g0hwan/Automated-Aquaponics-System/Mentoring/Readme.md

한이음 관련 멘토링 내용이 담길 예정입니다.

2026-04-12 18:00
랩에서 미팅

1.현재 하드웨어 상황 점검
 - 수경 재배 용 수조 관련 구현 중
 - 발아 환경에서 조명 이슈로 성장 차이 발생
    조명 온오프 조정으로 성장 조절 가능성 검토
 - 수확을 위한 그리퍼 적용된 로봇팔 구현 중

2.일정 및 관련 이슈
 - 졸업작품 심사대응 일정으로 진행
 - 구현 일정을 타이트하게 진행하여 마진을 확보하여 리스크 확보

3.기타
 - 시장에서 많이보이는 수경재배 제품에 관련하여 특징 및 장단점 검토
 - 4월은 중간고사 기간으로 시험 끝나면 추가 미팅진행예정

2026-05-21

1. 바이브 코딩 세미나 : 강의실
2. 프로젝트 진행상황 리뷰 : 랩

3. 바이브 코딩 세미나
   - 18:00 ~ 20:30
   - 인원 : 조희재강사(삼성전자) / 임세훈(멘토) / 김경환(멘티) / ----(청강)
   - 진행
       . VScode 워크스페이스 설정 및 코파일럿 설정 / 코덱스 설정
       . 채팅창을 이용한 코드 실습 : ESP32 + 네오LED
       . 사양서를 이용한 코드 실습 : ESP32 + 네오 LED + Wifi
       . AI에이전트 활용시 효율 올리는 방법 및 사양서의 중용성 / 기본템플릿 소개등
4. 프로젝트 리뷰
   - 20:30 ~21:00
   - 진행상황 및 이슈
      . 녹조발생관련 토론 : 조희재 강사의 무환수 어항 노하우 전달
                           바닥재 종류 바꾸기 / 달팽이와 새우를 이용한 녹조제거 등
5. 기타
 - 바이브 코딩은 추가 세미나 가능하며 일정확인
 - GITHUB활용건에대한 세미나도 추가

   2026-06-26 20:00
   1. 랩에서 진행상황미팅
      -  개발 상황 리뷰
      -  이슈검토 : 양액을 사용하면서 EC센서값 증가는 바닥재 등으로 정리되지만 PH가 증가하고있음
                   물고기 투입시 폐사 위험있어 데모는 소형 물고기 장난감으로 진행
      - 중간고사 완료되었으며 종강. 프로젝트 완성을 미리 하고 자료 정리등으로 일정 안배
      - 중간보고서 일정 확인 및 작성후 리뷰예정
   2. 회식
      - 근처 오이도 이동후 회식진행 : 상반기 노고 치하및 팀 화이팅 진행

      2026-07-31 19:30
 1. 기술혁신 파크 1층 스터디까페
   - 월요일 졸업작품 발표회 관련
     . 월요일 졸작발표회에서 스칼라 로봇의 고장발생이슈
     . 홍보용 촬영대응을 위해 수리 및 가동 점검 필요
   - 현업에서 AI 활용이슈
     . 보안이슈로 많은 제약이 있었지만 cluade 를 비롯한 다양한 AI 툴의 사용이 가능함.
     . 코드 생성 및 문서/ 분석등에서 산출물이 풍부하고 정확함. 생산성이 매우 높음. 이는 이전으로의 원복이 어려울것으로 보임
     . 학생일때 다양한 AI를 활용해볼것을 조언 
 2. 랩에서 프로젝트 체크
   - 발표를위해 이동을 하면서 분리된상태.
   - 한이음 최종 보고서 및 학교 홍보 영상 촬영을 위해 재조립은 필요한상화
 3. 기타
  - 중간 보고서 제출완료 및 우수 프로젝트 선정 축하
  - 미팅이후 석식으로 응원함.
