g0hwan/Automated-Aquaponics-System/Mentoring/KakaoTalk_20260523_161338244_03.jpg

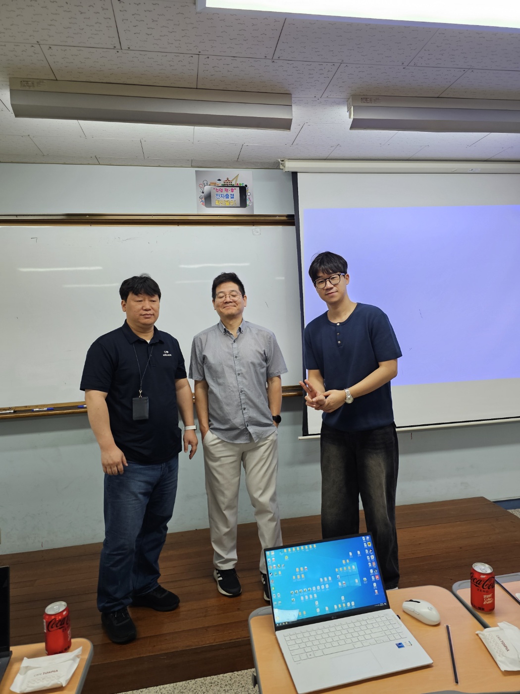
Mentoring/KakaoTalk_20260523_161338244_03.jpg
