g0hwan/Automated-Aquaponics-System/Mentoring/KakaoTalk_20260731_212931301_01.jpg

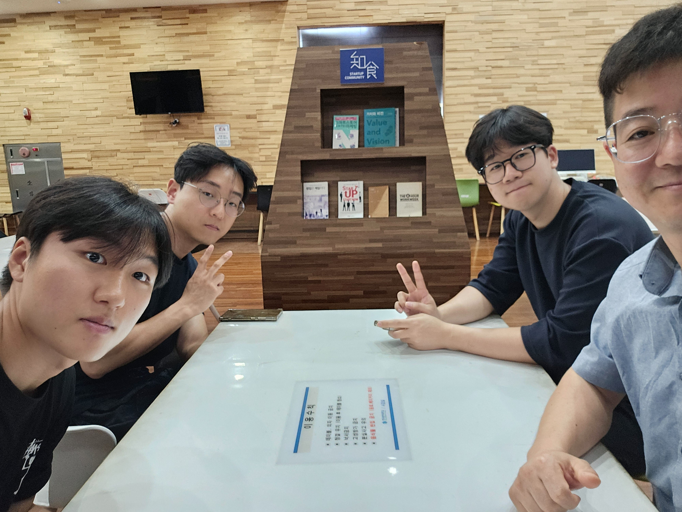
Mentoring/KakaoTalk_20260731_212931301_01.jpg
