g0hwan/Automated-Aquaponics-System/nursery/DS18B20_circuit.png

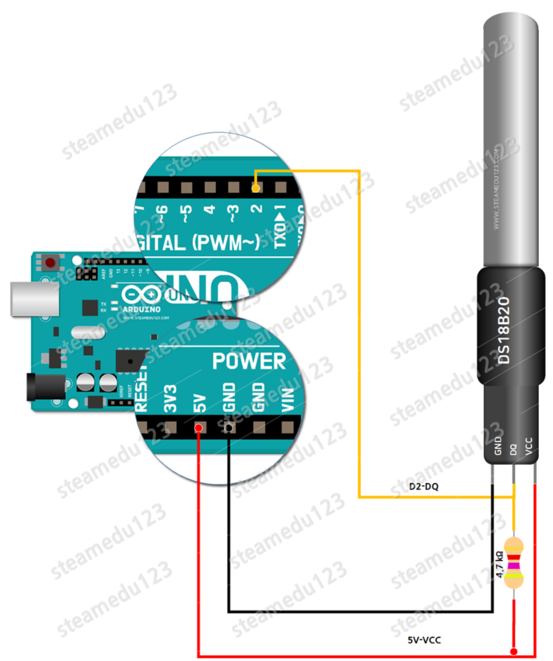
nursery/DS18B20_circuit.png
