g0hwan/Automated-Aquaponics-System/Mentoring/pc_ads1292r_brk_v3.pdf

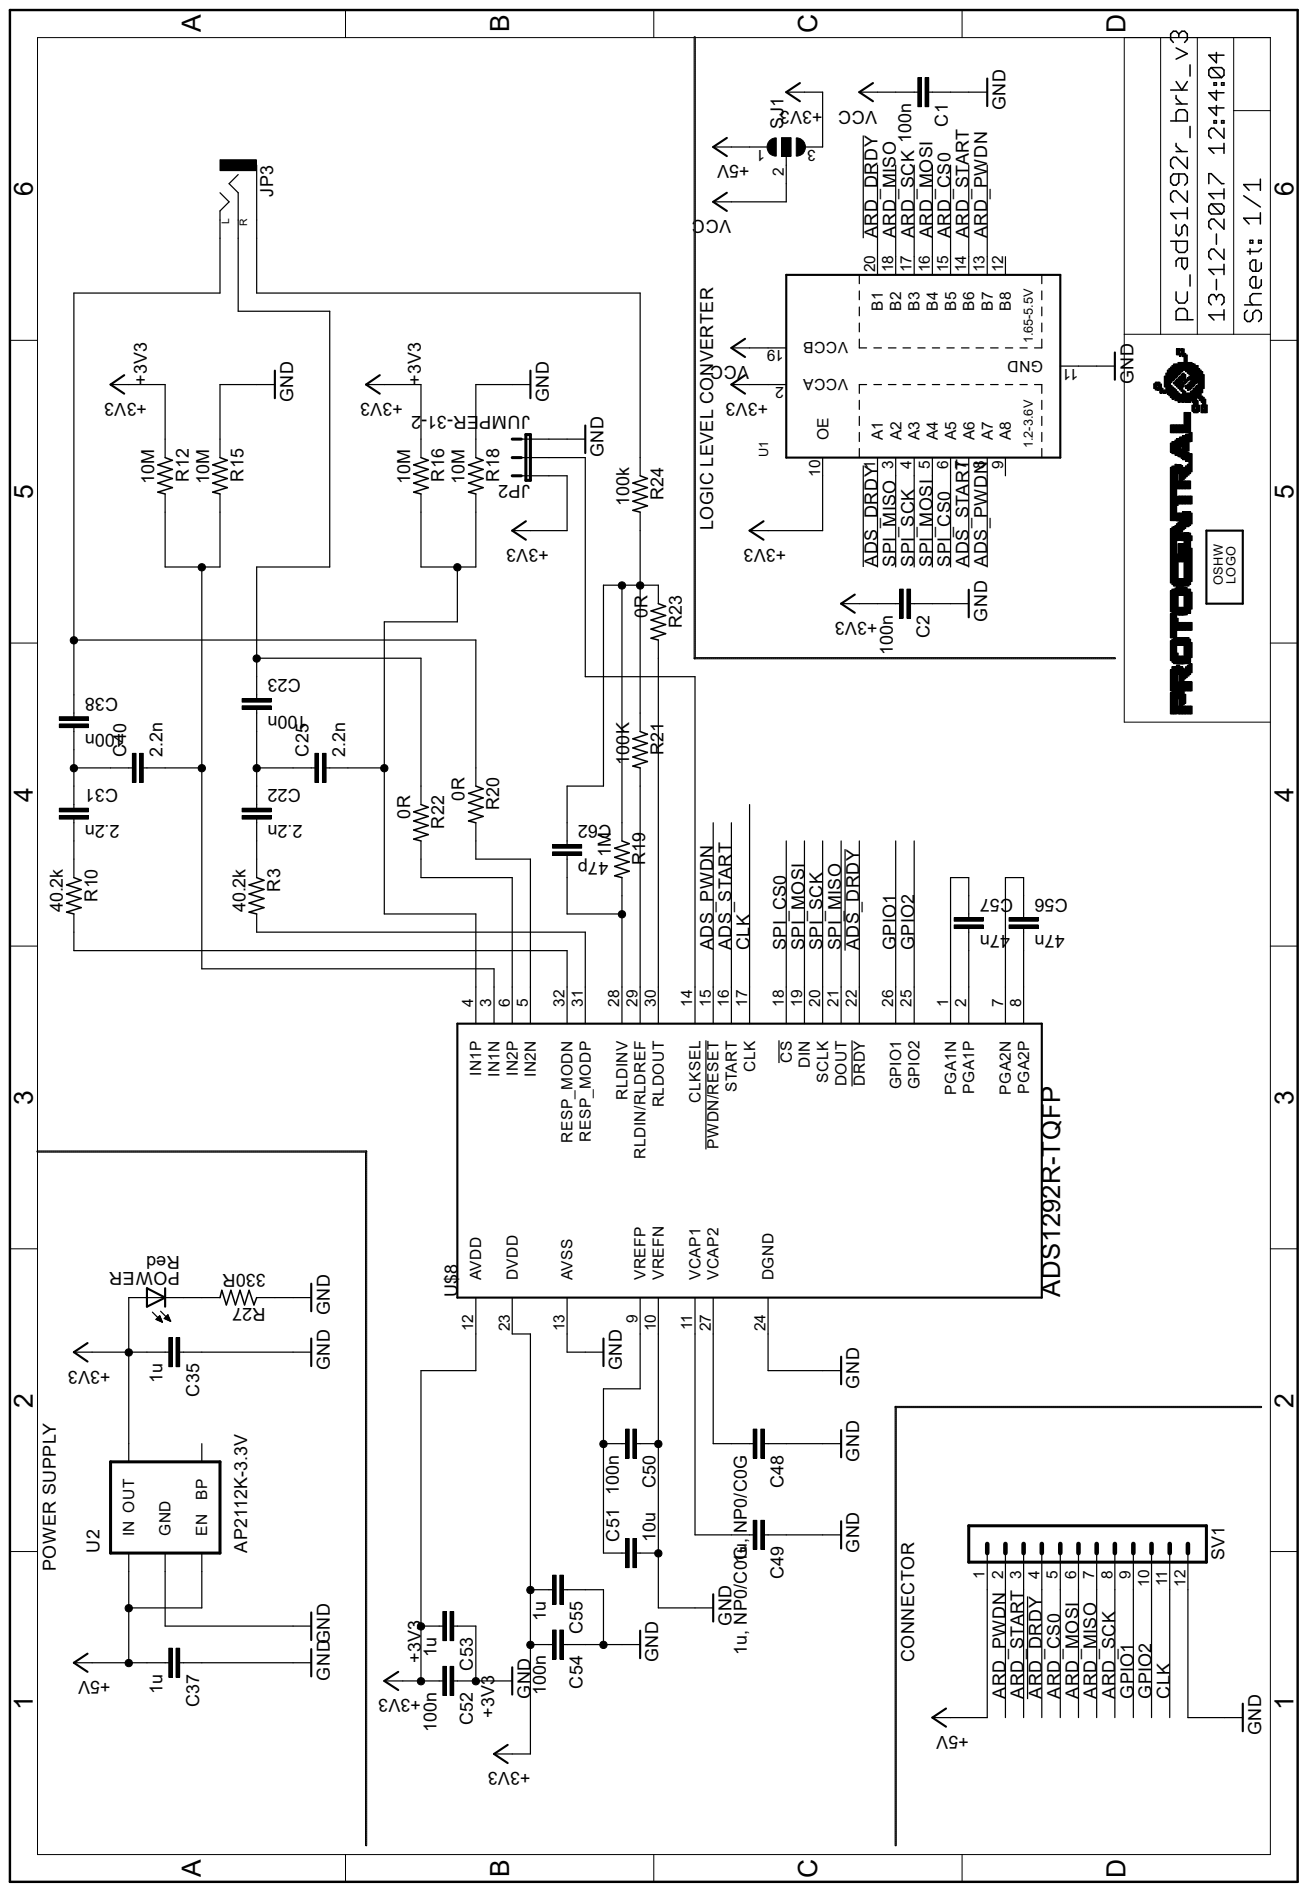
[picture p54: page 1]

2 U2INGNDOUT EN BP ADS_DRDY ADS_DRDY SPI_MISO SPI_MISO SPI_SCK SPI_SCK SPI_MOSI SPI_MOSI SPI_CS0 SPI_CS0 ADS_PWDN ADS_PWDN ADS_START ADS_START +3V3 +3V3 +3V3 +3V3 ARD_MOSI ARD_MOSI ARD_MISO ARD_MISO ARD_SCK ARD_SCK ARD_CS0 ARD_CS0 ARD_DRDY ARD_DRDY ARD_START ARD_START ARD_PWDN ARD_PWDN CLK CLK GPIO1 GPIO1 GPIO2 GPIO2

4 DIN 19 DOUT 21 SCLK 20 CS 18 DRDY 22 AVDD 12 AVSS 13 DVDD 23 GPIO1 26 GPIO2 25 RLDINV 28 RLDIN/RLDREF 29 RLDOUT 30 VREFP

9 VREFN 10 VCAP1 11 VCAP2 27 DGND 24 RESP_MODN 32 RESP_MODP 31 PWDN/RESET 15 CLK 17 START 16 CLKSEL 14 PGA1N
