g0hwan/Automated-Aquaponics-System/nursery/sens_hub/sens_hub.ioc

Mcu.UserName=STM32F446RETx
PA0-WKUP.Signal=ADCx_IN0
PA1.Signal=ADCx_IN1
PA2.Signal=USART2_TX
PA3.Signal=USART2_RX
PA4.Signal=GPIO_Output
PB0.Signal=GPIO_Output
PC0.Signal=GPIO_Output
