g0hwan/Automated-Aquaponics-System/nursery/sens_hub/Core/Src/main.c

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
/* Includes ------------------------------------------------------------------*/
#include "main.h"

/* USER CODE BEGIN Includes */
#include "sens.h"
#include "dht.h"
#include "ds18b20.h"
#include "relay_control.h"
/* USER CODE END Includes */

/* USER CODE BEGIN PTD */
void microDelay (uint16_t delay);
/* USER CODE END PTD */

ADC_HandleTypeDef hadc1;
ADC_HandleTypeDef hadc2;

TIM_HandleTypeDef htim2;
TIM_HandleTypeDef htim3;

UART_HandleTypeDef huart2;

void SystemClock_Config(void);
static void MX_GPIO_Init(void);
static void MX_ADC1_Init(void);
static void MX_ADC2_Init(void);
static void MX_TIM2_Init(void);
static void MX_USART2_UART_Init(void);
static void MX_TIM3_Init(void);
/* USER CODE BEGIN PFP */
void DWT_Delay_Init(void);
/* USER CODE END PFP */

/* USER CODE BEGIN 0 */
volatile uint32_t ms_tick = 0;
uint32_t t0 = 0;
uint8_t state = 0; // 0: idle, 1: waiting
/* USER CODE END 0 */

/**
  * @brief  The application entry point.
  * @retval int
  */
int main(void)
{

  /* MCU Configuration--------------------------------------------------------*/

  /* Reset of all peripherals, Initializes the Flash interface and the Systick. */
  HAL_Init();

  /* Configure the system clock */
  SystemClock_Config();

  /* USER CODE BEGIN SysInit */
  DWT_Delay_Init();
  /* USER CODE END SysInit */

  /* Initialize all configured peripherals */
  MX_GPIO_Init();
  MX_ADC1_Init();
  MX_ADC2_Init();
  MX_TIM2_Init();
  MX_USART2_UART_Init();
  MX_TIM3_Init();
  /* USER CODE BEGIN 2 */

  Relay_Init();

  HAL_TIM_Base_Start_IT(&htim2);
  HAL_ADC_Start(&hadc1);
  HAL_ADC_Start_IT(&hadc1);
  HAL_ADC_Start(&hadc2);
  HAL_ADC_Start_IT(&hadc2);
  HAL_TIM_Base_Start_IT(&htim3);
  /* USER CODE END 2 */

  /* Infinite loop */
  /* USER CODE BEGIN WHILE */
  while (1)
  {
	  if (ph_flag==1)
	  {
	      printf("tds = %lu, ph = %.2f\r\n", (unsigned long)tds_value, ph_value);

	      Relay_Control(ph_value, tds_value);

	      ph_flag = 0;
	  }
	  if(dht_flag)
	  {
	    dht_flag = 0;

	    float t,h;

	    uint32_t primask = __get_PRIMASK();
	    __disable_irq();                 // ✅ DHT 읽는 동안 인터럽트 금지

	    uint8_t ok = DHT22_Read(&t, &h);

	    if(!primask) __enable_irq();     // ✅ 원래 상태로 복구

	    if (ok) printf("DHT: T=%.1f H=%.1f\r\n", t, h);
	  }

	  if (state == 0) {
	      // 1초마다 변환 시작
	      static uint32_t last = 0;
	      if (ms_tick - last >= 1000)
	      {
	        last = ms_tick;

	        if (DS18B20_StartConversion())
	        {
	          t0 = ms_tick;
	          state = 1;
	        } else printf("DS18B20: NO PRESENCE\r\n");
	      }
	    }
	    else if (state == 1) {
	      if (ms_tick - t0 >= 750) {
	        float temp;
	        if (DS18B20_ReadTemp(&temp)) {
	          printf("T=%.2f\r\n", temp);
	        } else printf("DS18B20 FAIL\r\n");
	        state = 0;
	      }
	    }
    /* USER CODE END WHILE */

    /* USER CODE BEGIN 3 */
  }
  /* USER CODE END 3 */
}

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
/* USER CODE BEGIN 4 */
void DWT_Delay_Init(void)
{
  CoreDebug->DEMCR |= CoreDebug_DEMCR_TRCENA_Msk;
  DWT->CYCCNT = 0;
  DWT->CTRL |= DWT_CTRL_CYCCNTENA_Msk;
}

int dcnt, acnt;
void HAL_TIM_PeriodElapsedCallback(TIM_HandleTypeDef *htim)
{
	if(htim->Instance == TIM2)
	{
		dcnt++;
		acnt++;
		if (acnt == 1)
		{
			ph_flag = 1;
			tds_flag = 1;
			acnt=0;
		}
		if (dcnt == 4)
		{
			dht_flag = 1;
			dcnt = 0;
		}
	}
	if (htim->Instance == TIM3) {
	    ms_tick++;
	  }
}

/* USER CODE END 4 */
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
