g0hwan/Automated-Aquaponics-System/safe_hub/safe_hub/emergency.h

#ifndef EMERGENCY_H
#define EMERGENCY_H

#include <Arduino.h>

extern const byte stop_pin;
extern const byte start_pin;
extern const byte sw_pin;
extern const byte led_pin;

extern volatile bool emergencyLatched;
extern volatile bool startRequest;

void emergency_pin();
void stopISR();
void startISR();
bool SW();

#endif
