g0hwan/Automated-Aquaponics-System/sec_convey/Omx_Manual/step.h

#pragma once
#include <Arduino.h>

extern const int sw;
extern const int PUL;
extern const int DIR;
extern bool dir_state;

void stepPulse(bool dir, int speed);


//////////////////////////// 01.21 리니어레일 구동
void moveMM(bool dir, float mm, int speed);
void moveCM(bool dir, float cm, int speed);
////////////////////////////
extern bool stop_req;

void STOP_ISR();
void STOP_NOW();
void setstep();
void stepPulse(bool dir, int speed);
