g0hwan/Automated-Aquaponics-System/(commit log)

2025-12-26 12.26.20:03_프로젝트 파일 변경
2025-12-28 안전 허브 환경 구축
2025-12-28 12.29 05:46 수위센서 환경 세팅
2025-12-28 12.29 06:50 인터럽트 완료
2025-12-29 12.30 04:41 아직 센서허브 구축 중
2026-01-02 Create 문준익 웹
2026-01-02 01.02 20:56 ph, tds, dht 완료 (캘브x)
2026-01-03 01.03 21:12 센서 허브 완료
2026-01-04 01.05 06:16 안전허브 완료
2026-01-05 스카라 환경 세팅 중
2026-01-07 01.07 11:00 기구학 전단계까지 완료
2026-01-07 01.08 02:44 4축 동시 구동 완료(기구학 적용 전)
2026-01-08 01.09 02:30 기구학 코드 해석 끝
2026-01-10 01.11 04:21 로봇팔 동작(스텝모터는 아직)
2026-01-10 01.11 04:22 뭐 추가했더라?
2026-01-11 01.12 02:37 리드스크류 동작 가능
2026-01-14 01.14 17:43 세팅 끝
2026-01-14 스카라 세팅 80완료
2026-01-14 매니퓰레이터 세팅 완료
2026-01-14 매니퓰레이터 메뉴얼 추가
2026-01-16 카메라 초기 셋팅
2026-01-17 01.18 12:05 컨베이어, 적외선센서, 절대거리센서
2026-01-19 카메라 각도 전송
2026-01-19 각도 받기 추가
2026-01-20 캠 캘브
    [camera_calib.yaml]
2026-01-21 01.21 19:55 리니어레일 cm, mm단위 이동 코드
2026-01-21 01.21 19:59 리니어레일 cm, mm함수 추가
2026-01-23 전체 업데이트
2026-01-24 01.24 22:00 스카라 홈위치 구현 중(z,j3 완)
2026-01-24 01.25 02:12 j4까지 완료
2026-01-27 01.27 19:12 기구학 수정 중
    [move.cpp, pid.cpp, scara_pid.ino, set_motor.h]
2026-01-27 기구학 수정 중
2026-01-27 01.27 23:09 스카라 각도, 좌표 캘브, en하는중
2026-01-28 01.28 15:00 모터en설정
2026-01-28 리니어 레일 추가 중
2026-01-28 01.28 23:35 전자석, 리니어 레일 추가
2026-01-29 01/30 01:50 스카라 각도, 좌표
2026-02-01 02.01 20:00 상대좌표계 추가
2026-02-06 02.07 02:16 스카라 상대 좌표 완료
2026-02-07 02.07 22:15 기타 버그 수정
    [main.c, move.cpp, scara_pid.ino, set_motor.h]
2026-03-21 pc-라파1-stm통신, pc-라파2-stm 총신. 라파2는 매니퓰레이터 스카라 통신 추가 예정
2026-03-21 pc통신. pi1 pi2와 ros통신
2026-03-21 첫번째 컨베이어 라파
2026-03-21 두번째 컨베이어 라파(스카라, 매니퓰레이터 추가 예정)
2026-03-29 26.03.29 22:00 스카라 통신 구축 시작
2026-03-29 캠 코드 수정
2026-03-29 기타 버그 수정
2026-04-01 26.04.01 15:30 알고리즘 구현 중
2026-04-02 26.04.02 21:47 업뎃
2026-04-02 멘토링 파일 추가
2026-04-02 확장자 변경
2026-04-09 통신 내용 추가
2026-04-09 sect3 수정 중
2026-04-13 0412 미팅 회의록
    0412 미팅 회의록
2026-04-13 문단 정리
    문단 정리
2026-04-24 26.04.24 4월 회의록 등록
2026-05-13 26.05.14 02:40 트레이 받침추가
2026-05-13 26.05.14 02:41 버그 수정 + 메뉴얼 기능 추가
    [Omx_Manual.ino, step.cpp, step.h, utils.h]
2026-05-23 5월 바이브 코딩 세미나 및 과제 리뷰
    5월 바이브 코딩 세미나 및 과제 리뷰
2026-05-23 5월 세미나 사진
2026-05-25 5월 회의록 추가
2026-06-27 6월 멘토링
    6월 멘토링
2026-07-02 6월 멘토링
    Added details about project meet6월 멘토링ngs and team dinner.
2026-07-07 센서 허브 수정
2026-07-07 첫 번째 컨베이어 수정
    [sens_hub.ioc]
2026-07-07 스카라 펌웨어 끝
2026-07-18 스카라 26.07.18 21:00
2026-07-22 26.07.22 스카라 시퀀스 끝, pathTask 수정 해야함
    [move.cpp, path.cpp, scara_pid.ino, set_motor.h]
2026-07-26 Add files via upload
    css 추가 수정
2026-08-01 7월 멘토링
    Added updates regarding project presentations and AI tool usage.
2026-08-01 멘토링 사진
2026-08-03 Replace conveyor files from thumb_first_con
    [move.cpp, path.cpp, pid.cpp, scara_pid.ino, set_motor.h]
2026-08-03 Replace SCARA PID files
    [move.cpp, path.cpp, pid.cpp, scara_pid.ino, set_motor.h]
2026-08-08 스카라 .ino파일
2026-08-08 보드 핀 설정
2026-08-17 매니퓰레이터
2026-08-17 스카라 시퀀스 수정
2026-09-06 최신버전 업데이트
2026-10-06 욜로파일
2026-10-12 README 한이음
