g0hwan/Automated-Aquaponics-System/(notices)

Notices in the files:
nursery/sens_hub/Core/Src/main.c:
Copyright (c) 2025 STMicroelectronics.
All rights reserved.
This software is licensed under terms that can be found in the LICENSE file
