g0hwan/Automated-Aquaponics-System/Mentoring/20260626_194922.jpg

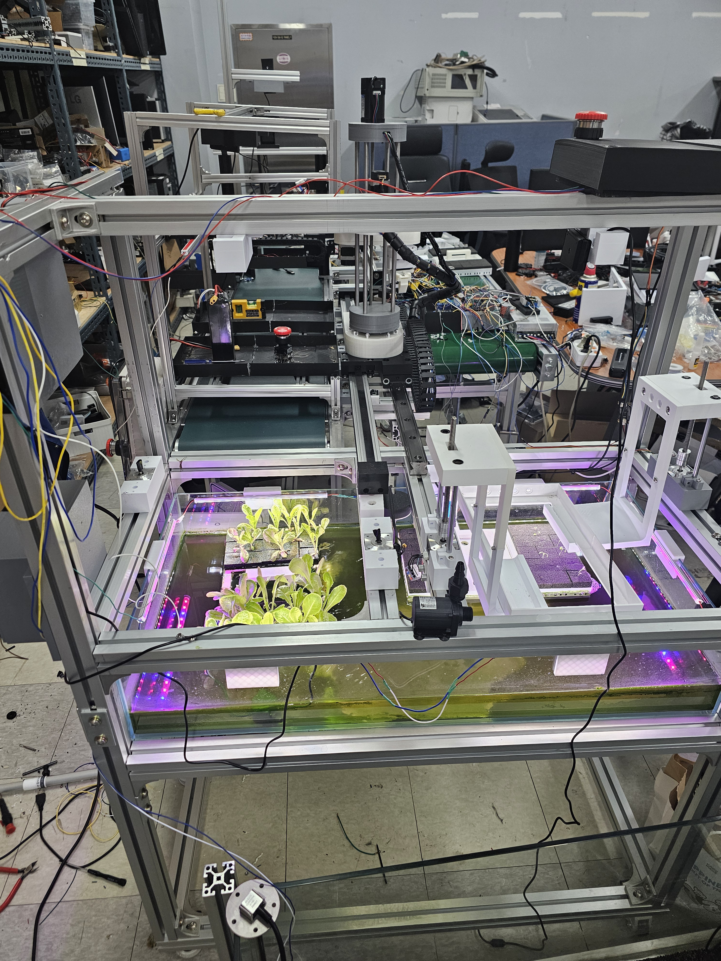
Mentoring/20260626_194922.jpg
