g0hwan/Automated-Aquaponics-System/Mentoring/KakaoTalk_20260412_181324089_01.jpg

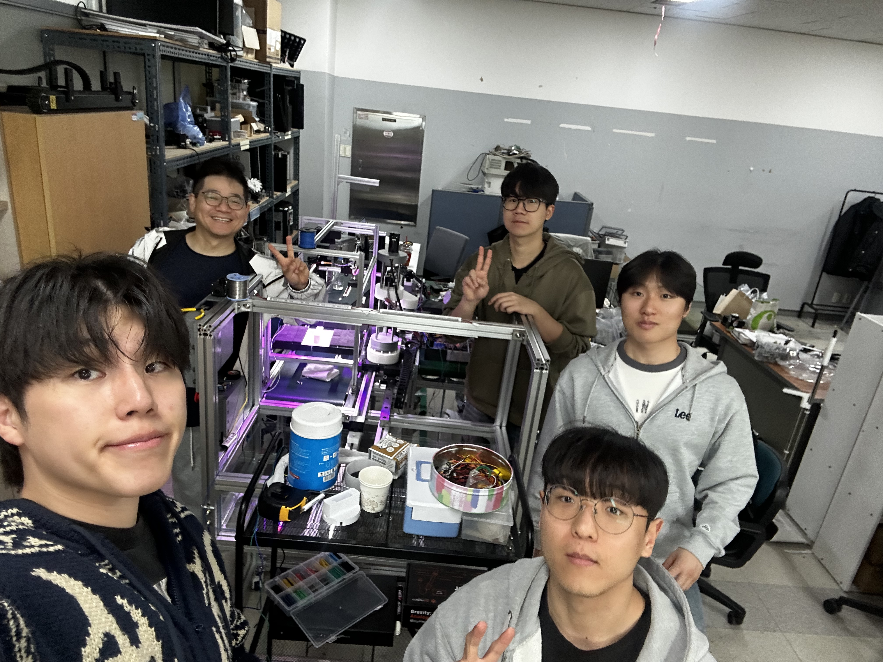
Mentoring/KakaoTalk_20260412_181324089_01.jpg
